Dmytry/ZProbe/(commit log)

2018-09-08 Initial commit, pre-print
    [z_probe_0.scad]
2018-09-08 way to view pieces separately
    [z_probe_0.scad]
2018-09-08 About to add rack and pinion mechanism, cleaning up boilerplate
    [z_probe_0.scad]
2018-09-08 added gear
    [z_probe_0.scad]
2018-09-09 correct gear diameter
    [z_probe_0.scad]
2018-09-12 Rack set up, todo: use hull to make it neater
    [z_probe_0.scad]
2018-09-12 rack model using hull
    [z_probe_0.scad]
2018-09-16 use small 5x1 mm magnets for holding the probe.
    [z_probe_0.scad]
2018-09-30 Added holes so it can be build with only 5mm magnets
    [z_probe_0.scad]
